bhamla-lab/OpenCell/OpenCell Raw Data.xlsx

Sheet: Time Characterization
Sample | Mass (g) | Elution (ul) | Conc (ng/ul) | A260/A280 | Yield (ng) | Time
A1 |  | 50 | 20.8 | 1.64 | 1040 | 30
A2 |  | 50 | 25.3 | 1.49 | 1265 | 30
A3 |  | 50 | 16.7 | 1.52 | 835 | 30
____
B1 |  | 50 | 27.8 | 1.8 | 1390 | 60
B2 |  | 50 | 29.3 | 1.76 | 1465 | 60
B3 |  | 50 | 19.5 | 1.77 | 975 | 60
_____
C1 |  | 50 | 41.9 | 1.8 | 2095 | 120
C2 |  | 50 | 42.7 | 1.83 | 2135 | 120
C3 |  | 50 | 48.9 | 1.84 | 2445 | 120
____
D1 |  | 50 | 55.8 | 1.82 | 2790 | 180
D2 |  | 50 | 57.3 | 1.79 | 2865 | 180
D3 |  | 50 | 53.4 | 1.82 | 2670 | 180
___
E1 |  | 50 | 60.6 | 1.82 | 3030 | 300
E2 |  | 50 | 56.1 | 1.8 | 2805 | 300
E3 |  | 50 | 58.7 | 1.81 | 2935 | 300
____
F1
F2
F3

Sheet: Speed Characterization
Sample | Mass (g) | Elution (ul) | Conc (ng/ul) | A260/A280 | Yield (ng) | Speed
A1 |  | 50 | 17.5 | 1.32 | 875 | 425
A2 |  | 50 | 6.7 | 1.62 | 335 | 425
A3 |  | 50 | 16.3 | 1.42 | 815 | 425
____
B1 |  | 50 | 15.6 | 1.69 | 780 | 550
B2 |  | 50 | 22.3 | 1.72 | 1115 | 550
B3 |  | 50 | 16.6 | 1.7 | 830 | 550
_____
C1 |  | 50 | 38.7 | 1.79 | 1935 | 725
C2 |  | 50 | 31.5 | 1.76 | 1575 | 725
C3 |  | 50 | 36.2 | 1.82 | 1810 | 725
____
D1 |  | 50 | 40 | 1.77 | 2000 | 850
D2 |  | 50 | 44.7 | 1.8 | 2235 | 850
D3 |  | 50 | 41.5 | 1.78 | 2075 | 850
___
E1 |  | 50 | 43.2 | 1.79 | 2160 | 1000
E2 |  | 50 | 48.5 | 1.82 | 2425 | 1000
E3 |  | 50 | 45.7 | 1.82 | 2285 | 1000

Sheet: Centrifuge Characterization
Sample | Mass (g) | Elution (ul) | Conc (ng/ul) | A260/A280 | Yield (ng)
A1 |  | 50 | 45.8 | 1.32 | 2290 | 0.5
A2 |  | 50 | 43.6 | 1.62 | 2180 | 0.5
A3 |  | 50 | 35.3 | 1.43 | 1765 | 0.5
____
B1 |  | 50 | 47.5 | 1.69 | 2375 | 1
B2 |  | 50 | 43.3 | 1.62 | 2165 | 1
B3 |  | 50 | 50.7 | 1.7 | 2535 | 1
_____
C1 |  | 50 | 51.3 | 1.79 | 2565 | 1.5
C2 |  | 50 | 54.7 | 1.76 | 2735 | 1.5
C3 |  | 50 | 52.5 | 1.72 | 2625 | 1.5
____
D1 |  | 50 | 51.8 | 1.77 | 2590 | 2
D2 |  | 50 | 52.6 | 1.8 | 2630 | 2
D3 |  | 50 | 55.9 | 1.76 | 2795 | 2
___
E1 |  | 50 | 53.4 | 1.81 | 2670 | 2.5
E2 |  | 50 | 53.5 | 1.84 | 2675 | 2.5
E3 |  | 50 | 54.7 | 1.8 | 2735 | 2.5

Sheet: OCX vs Commercial
Sample | Mass (g) | Elution (ul) | Conc (ng/ul) | A260/A280 | Yield (ng)
A1 | 0.0508 | 50 | 59.2 | 1.76 | 2960
 | 0.0508 | 50 | 55.1 | 1.74 | 2755 | 1.75 | 2857.5
A2 | 0.0492 | 50 | 48.5 | 1.77 | 2425
 | 0.0492 | 50 | 48.9 | 1.74 | 2445 | 1.755 | 2435
A3 | 0.0495 | 50 | 50 | 1.82 | 2500
 | 0.0495 | 50 | 50.1 | 1.76 | 2505 | 1.79 | 2502.5
A4 | 0.0497 | 50 | 34.1 | 1.76 | 1705
 | 0.0497 | 50 | 34.4 | 1.76 | 1720 | 1.76 | 1712.5
A5 | 0.0506 | 50 | 40.8 | 1.74 | 2040
 | 0.0506 | 50 | 40.2 | 1.74 | 2010 | 1.74 | 2025
A6 | 0.0503 | 50 | 38.2 | 1.72 | 1910
 | 0.0503 | 50 | 36.2 | 1.74 | 1810 | 1.73 | 1860
A7 | 0.0504 | 50 | 47.6 | 1.73 | 2380
 | 0.0504 | 50 | 43.3 | 1.71 | 2165 | 1.72 | 2272.5
____
B1 | 0.0505 | 50 | 45.9 | 1.83 | 2295
 | 0.0505 | 50 | 43.2 | 1.79 | 2160 | 1.81 | 2227.5
B2 | 0.05 | 50 | 55.9 | 1.77 | 2795
 | 0.05 | 50 | 55.4 | 1.77 | 2770 | 1.77 | 2782.5
B3 | 0.0505 | 50 | 44.8 | 1.82 | 2240
 | 0.0505 | 50 | 45.1 | 1.82 | 2255 | 1.82 | 2247.5
B4 | 0.0503 | 50 | 45 | 1.75 | 2250
 | 0.0503 | 50 | 45.4 | 1.75 | 2270 | 1.75 | 2260
B5 | 0.0494 | 50 | 45.2 | 1.81 | 2260
 | 0.0494 | 50 | 45.1 | 1.8 | 2255 | 1.805 | 2257.5
B6 | 0.0502 | 50 | 45.5 | 1.82 | 2275
 | 0.0502 | 50 | 46.1 | 1.82 | 2305 | 1.82 | 2290
B7 | 0.0496 | 50 | 51.2 | 1.8 | 2560
 | 0.0496 | 50 | 51.4 | 1.79 | 2570 | 1.795 | 2565
____
C1 | 0.0502 | 50 | 1.5 | 1.28 | 75 | 1494.023904
C2 | 0.0496 | 50 | 2.4 | 1.3 | 120 | 2419.354839
C3 | 0.0504 | 50 | 1.6 | 1.24 | 80 | 1587.301587
C4 | 0.0503 | 50 | 1.6 | 1.26 | 80 | 1590.457256
C5 | 0.0502 | 50 | 1.9 | 1.29 | 95 | 1892.430279

Sheet: GEL
GEL | PCR | Extraction
1 | Ladder
2 | A | A3
3 | B | A4
4 | C | A5
5 | D | A7
6
7 | Ladder
8 | E | B3
9 | F | B4
10 | G | B5
11 | H | B6
12 | TEST | (A1)
13

Sheet: High Speed Tracking
Time | 560 RPM | 700 RPM | 800 RPM | 1000 RPM
0 | -35.75543857 | -35.52404484 | -36.2382883 | -35.52308178
0.00022543 | -35.88779777 | -36.04226227 | -36.56577593 | -35.63879852
0.00045086 | -35.45374428 | -35.54677528 | -36.42872528 | -35.7624298
0.00067628 | -35.4414147 | -34.98313727 | -36.38749202 | -35.14864865
0.00090171 | -35.41839807 | -35.6372435 | -35.94955959 | -35.28809372
0.00112714 | -34.94925267 | -35.42057309 | -35.65259904 | -35.34769076
0.00135257 | -34.52787957 | -35.98616935 | -36.35921868 | -34.858677
0.001578 | -34.71435647 | -35.84451274 | -36.16508656 | -35.17989385
0.00180343 | -34.78617925 | -35.77580336 | -36.33334219 | -35.33193965
0.00202885 | -34.6235922 | -35.86993852 | -35.9289952 | -35.16734282
0.00225428 | -34.86983095 | -35.25020861 | -35.79301172 | -35.20688794
0.00247971 | -34.69298589 | -35.54009208 | -36.17531276 | -35.28925854
0.00270514 | -34.83938178 | -34.80196914 | -35.98149678 | -35.18253027
0.00293057 | -34.11354627 | -34.73131728 | -36.16573586 | -35.11332904
0.003156 | -34.20888934 | -34.98559613 | -35.62898615 | -34.85259407
0.00338142 | -34.18095869 | -35.02464924 | -35.54104655 | -35.03985329
0.00360685 | -33.84301151 | -35.33750341 | -35.97091755 | -34.81114285
0.00383228 | -34.55751446 | -34.69764365 | -35.56003494 | -34.91100359
0.00405771 | -34.3906868 | -35.12081467 | -36.00930667 | -35.22079401
0.00428314 | -34.37292448 | -35.03177248 | -35.88035619 | -34.87837015
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
0.10504959 | -35.32602402
0.10527502 | -35.38032305
0.10550045 | -35.01405862
0.10572588 | -35.37101043
0.10595131 | -35.10039014
0.10617674 | -34.86444053
0.10640216 | -35.41439969
0.10662759 | -35.15540144
0.10685302 | -35.31554958
0.10707845 | -35.10895664
0.10730388 | -34.90107331
