bhamla-lab/OpenCell/STL Files/Centrifuge Attachment/Centrifuge Attachment.stl

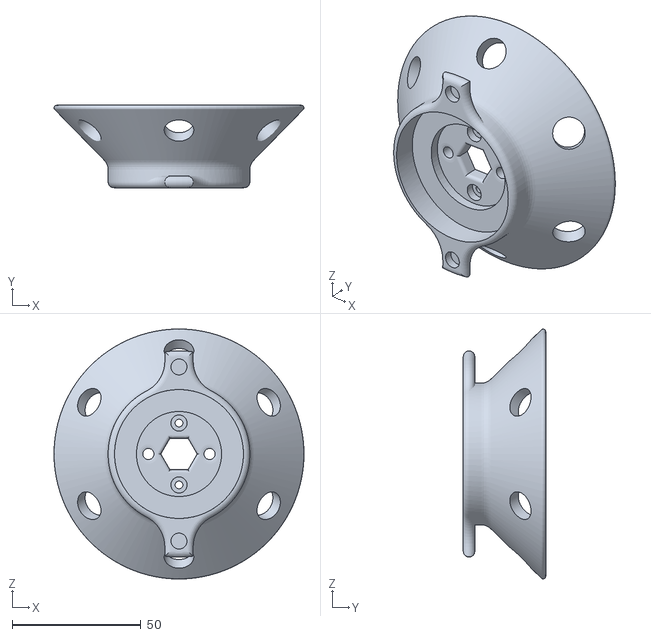
[picture p1: CAD file, 2023-09-28]
STL Files/Centrifuge Attachment/Centrifuge Attachment.stl
97.0 x 32.0 x 97.0
