bhamla-lab/OpenCell/STL Files/Lysis Attachment/Secondary Gear.stl

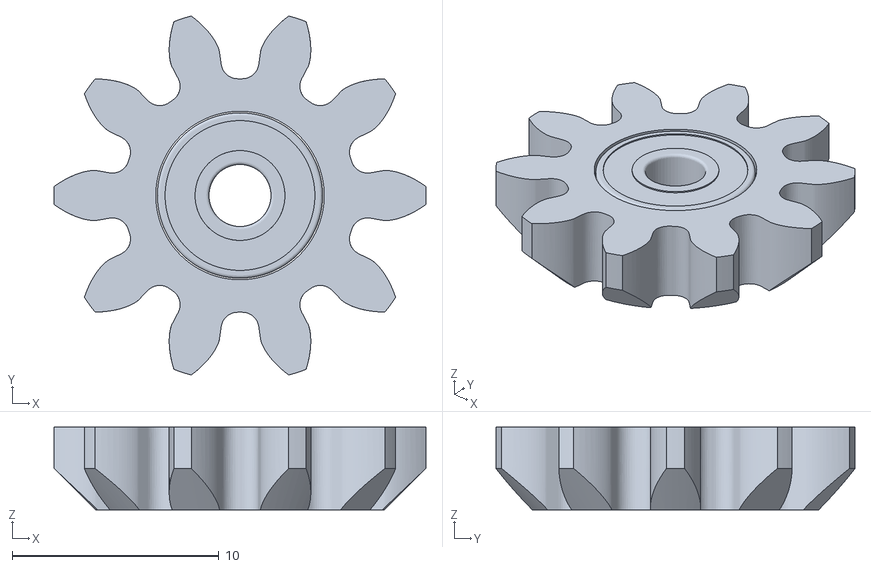
[picture p2: CAD file, 2023-10-03]
STL Files/Lysis Attachment/Secondary Gear.stl
18.0 x 17.4 x 4.00
