bhamla-lab/OpenCell/STL Files/Platform/Button Holder.stl

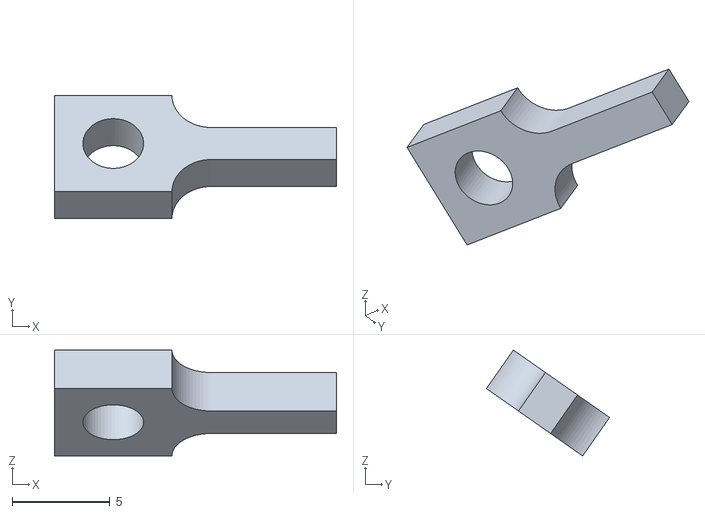
[picture p3: CAD file, 2023-10-03]
STL Files/Platform/Button Holder.stl
14.4 x 6.29 x 5.41
