bhamla-lab/OpenCell/STL Files/Lysis Attachment/Tertiary Gear.stl

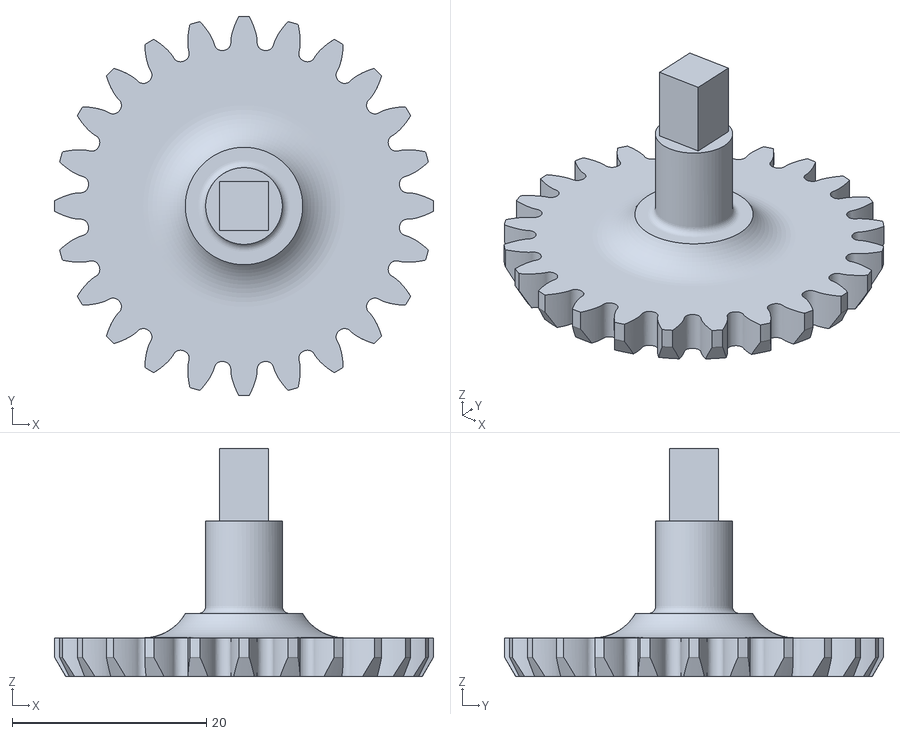
[picture p4: CAD file, 2023-10-03]
STL Files/Lysis Attachment/Tertiary Gear.stl
39.0 x 39.0 x 23.5
