bhamla-lab/OpenCell/STL Files/Platform/Face.stl

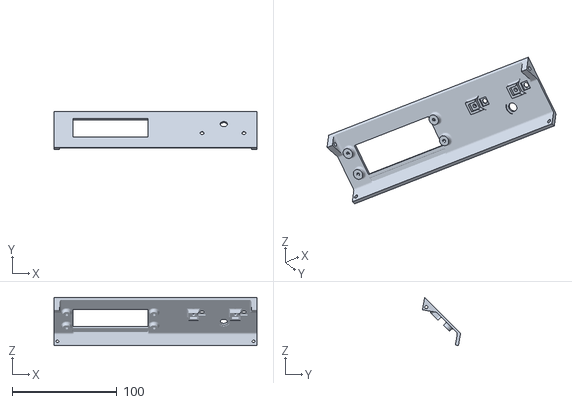
[picture p5: CAD file, 2023-10-03]
STL Files/Platform/Face.stl
194.0 x 36.5 x 46.0
