bhamla-lab/OpenCell/STL Files/Lysis Attachment/Tube Strap.stl

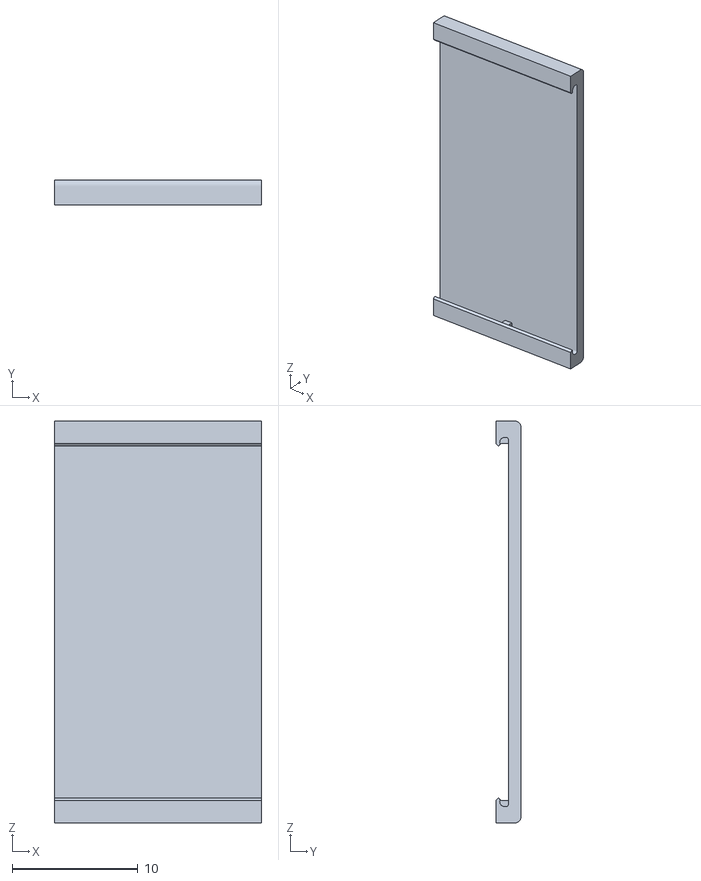
[picture p6: CAD file, 2023-09-28]
STL Files/Lysis Attachment/Tube Strap.stl
16.5 x 2.00 x 32.0
