bhamla-lab/OpenCell/STL Files/Platform/Electronics Enclosure.stl

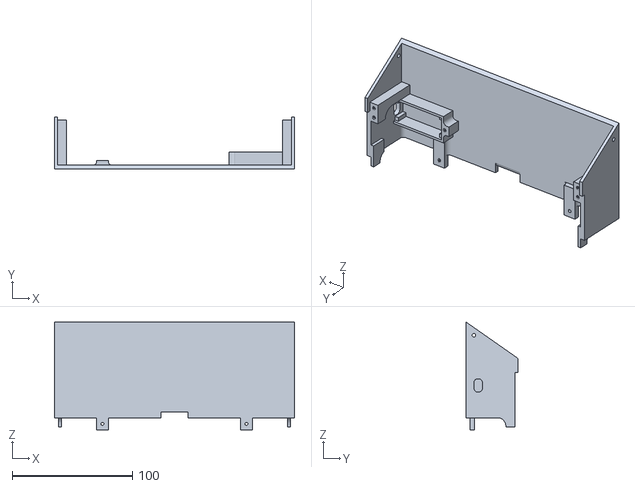
[picture p7: CAD file, 2023-10-03]
STL Files/Platform/Electronics Enclosure.stl
200.0 x 43.0 x 89.8
