bhamla-lab/OpenCell/STL Files/Lysis Attachment/Tube Cradle Base.stl

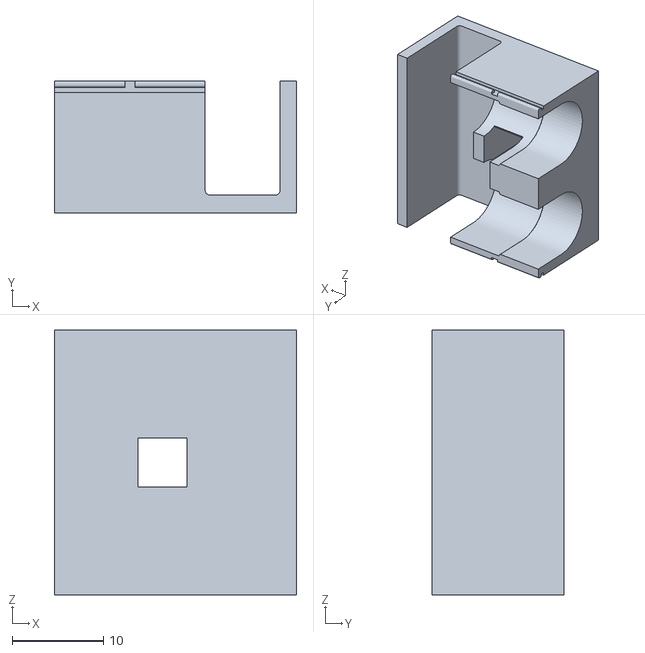
[picture p8: CAD file, 2023-03-24]
STL Files/Lysis Attachment/Tube Cradle Base.stl
26.5 x 14.5 x 29.0
