bhamla-lab/OpenCell/STL Files/Platform/Electronics Lid.stl

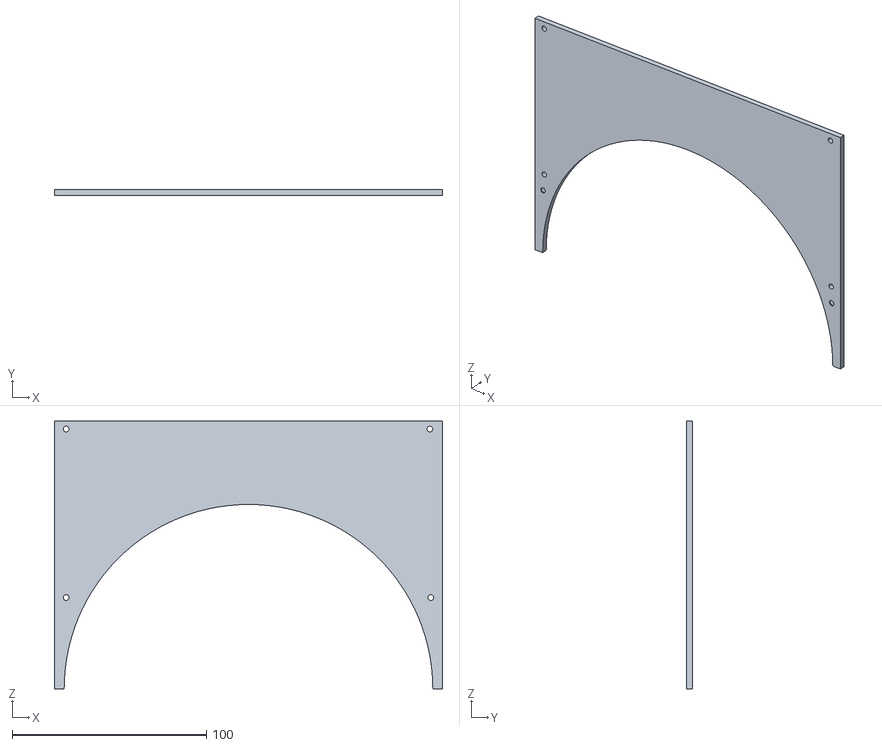
[picture p9: CAD file, 2023-09-28]
STL Files/Platform/Electronics Lid.stl
200.0 x 3.00 x 137.9
