bhamla-lab/OpenCell/STL Files/Lysis Attachment/Lower Arm.stl

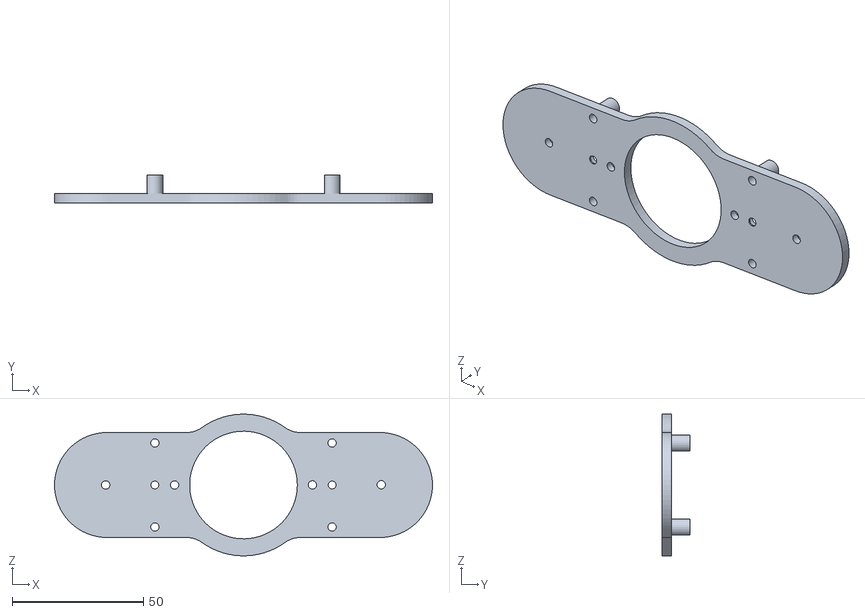
[picture p10: CAD file, 2023-03-24]
STL Files/Lysis Attachment/Lower Arm.stl
144.0 x 10.5 x 54.0
