bhamla-lab/OpenCell/STL Files/Platform/Chamber.stl

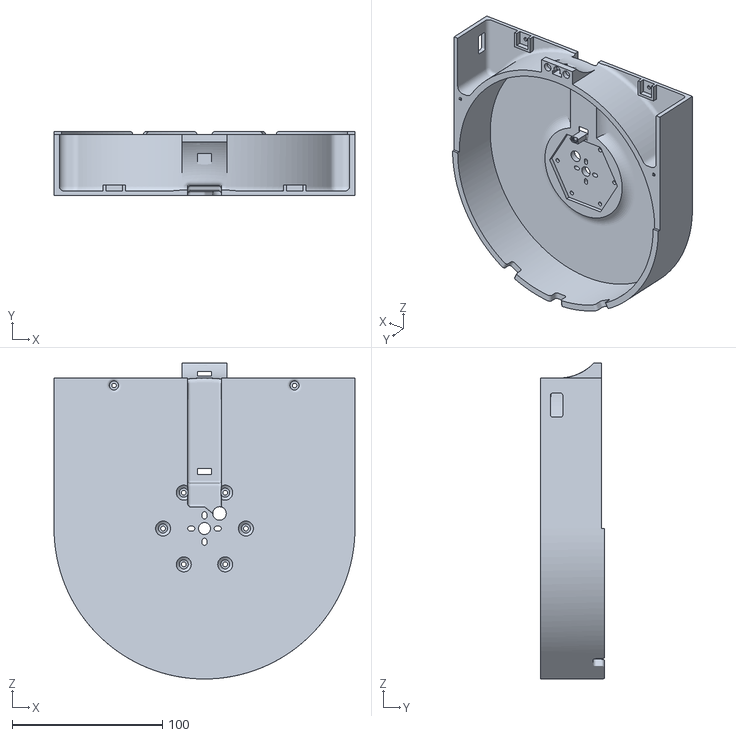
[picture p11: CAD file, 2023-09-28]
STL Files/Platform/Chamber.stl
200.0 x 42.5 x 210.0
