bhamla-lab/OpenCell/STL Files/Lysis Attachment/Upper Arm.stl

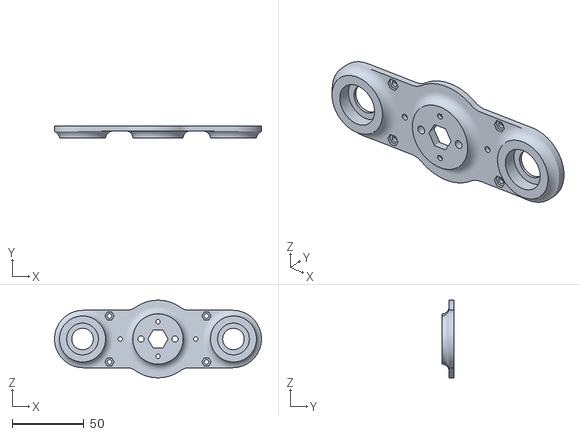
[picture p12: CAD file, 2023-03-24]
STL Files/Lysis Attachment/Upper Arm.stl
144.0 x 8.50 x 54.0
