bhamla-lab/OpenCell/STL Files/Platform/Lid.stl

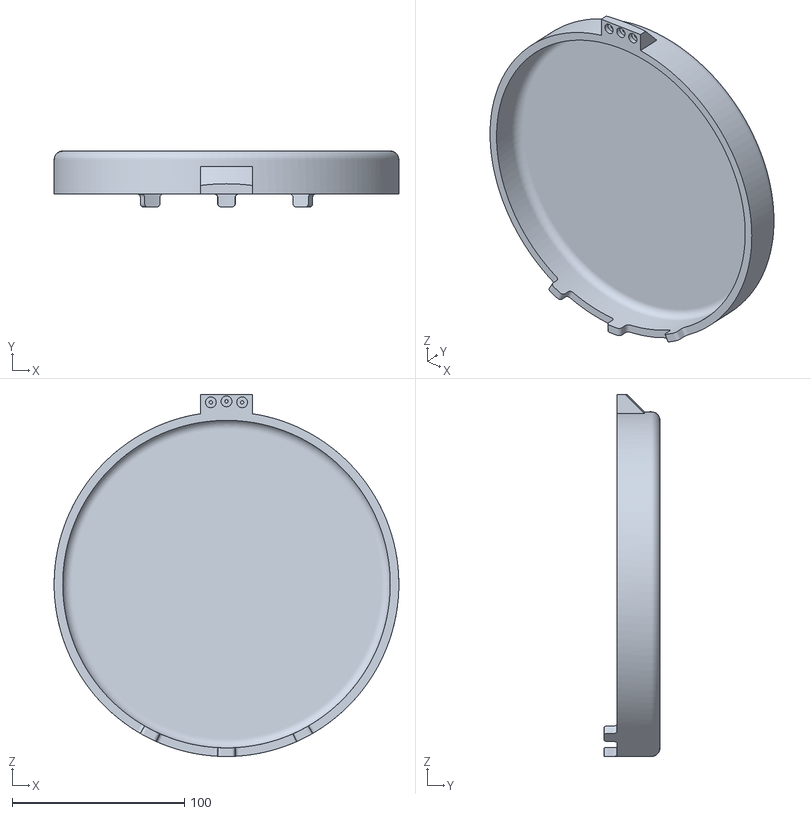
[picture p13: CAD file, 2023-09-28]
STL Files/Platform/Lid.stl
200.0 x 32.5 x 210.0
