bhamla-lab/OpenCell/STL Files/Platform/Motor Mount.stl

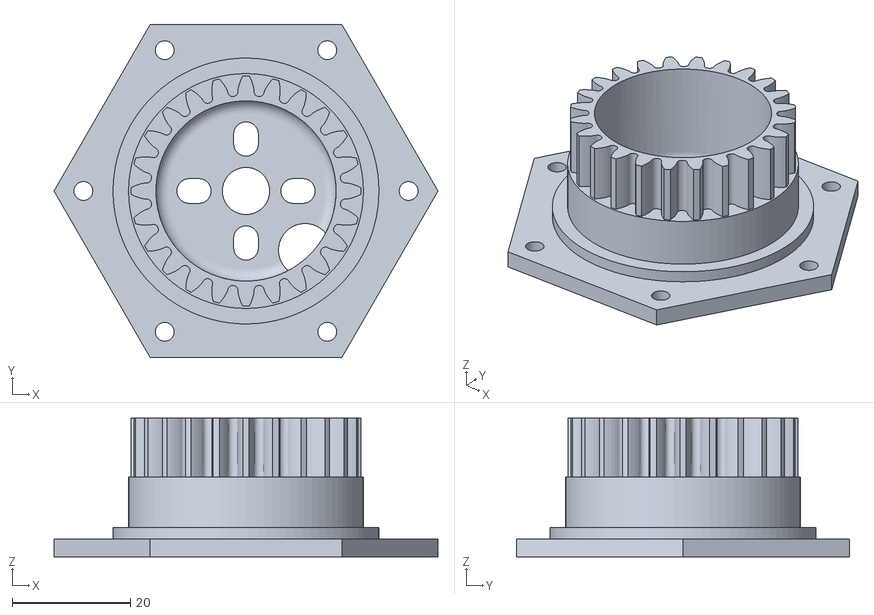
[picture p14: CAD file, 2023-03-24]
STL Files/Platform/Motor Mount.stl
65.0 x 56.3 x 23.5
