bhamla-lab/OpenCell/STL Files/Platform/Quick Release Mount.stl

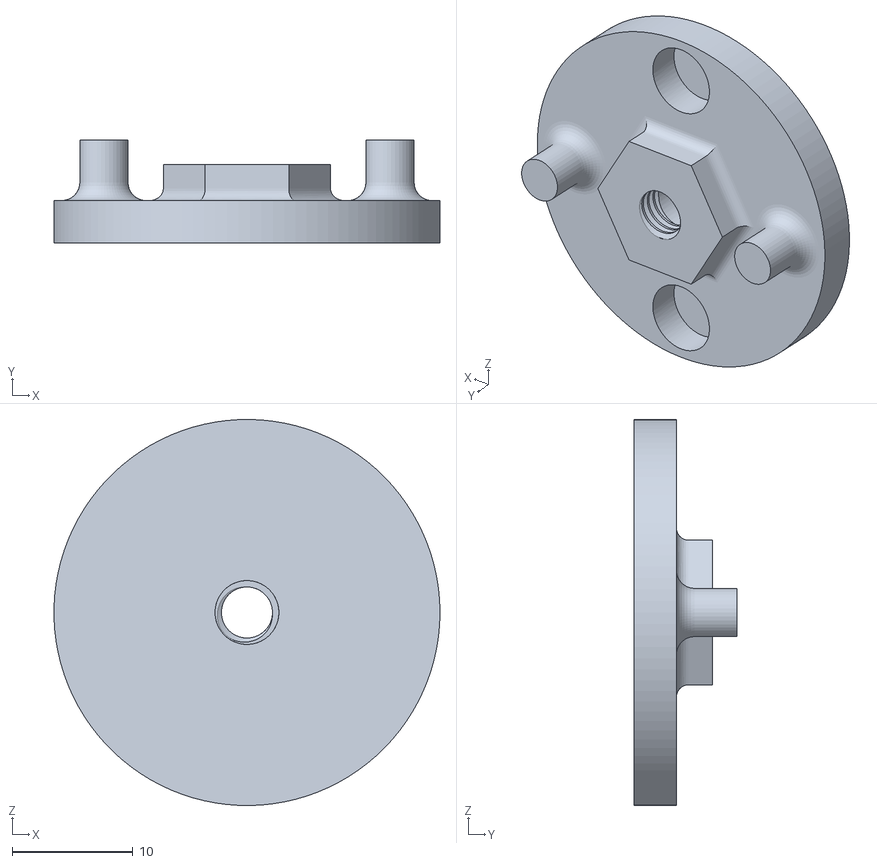
[picture p15: CAD file, 2023-03-24]
STL Files/Platform/Quick Release Mount.stl
32.0 x 8.50 x 32.0
