bhamla-lab/OpenCell/OpenCell_PID/OpenCell_PID.ino

//OPENCELL PID CODE
//BhamlaLab - Georgia Institute of Technology
//Aryan Gupta

//USING CODE ADAPTED FROM https://www.youtube.com/watch?v=u2uJMJWsfsg
/*
  This verion of the code is reccomended for experienced programmers. A PID allows for accurate and precise control.
  A PID must be tuned and improper implementation can lead to instability, component damage, and overheating.
  We reccomend a low Kp value and a slightly overdamped system.
*/

#include <Servo.h>
#include <Wire.h>
#include <LiquidCrystal_I2C.h>
#define rightBtn 5
#define leftBtn 4
#define dial A3
#define tach 2
#define motor 3
#define lidSensor 6
float Kp = 0;
float Ki = 0;
float Kd = 0;
float Kc = 0;
float FF = 0;

float Kpc = 0;
float Kic = 0;
float Kdc = 0;
float Kcc = 0; 
float FFc = 0;

float rateLimiter = 100;
int mode = 0;
LiquidCrystal_I2C lcd(0x27, 16, 2);
Servo esc;
int potValue;
unsigned long lastTime_print = 0;


const byte PulsesPerRevolution = 2;  // Set how many pulses there are on each revolution. Default: 2.
const unsigned long ZeroTimeout = 200000;
const byte numReadings = 2;

volatile unsigned long LastTimeWeMeasured;
volatile unsigned long PeriodBetweenPulses = ZeroTimeout + 1000; 
volatile unsigned long PeriodAverage = ZeroTimeout + 1000;
unsigned long FrequencyRaw;
unsigned long FrequencyReal;
unsigned long RPM;
unsigned int PulseCounter = 1;

unsigned long PeriodSum;
unsigned long LastTimeCycleMeasure = LastTimeWeMeasured;

unsigned long CurrentMicros = micros();

unsigned int AmountOfReadings = 1;

unsigned int ZeroDebouncingExtra;


unsigned long readings[numReadings];
unsigned long readIndex;
unsigned long total;
unsigned long average;

void setup()  // Start of setup:
{
  pinMode(rightBtn, INPUT_PULLUP);
  pinMode(leftBtn, INPUT_PULLUP);
  pinMode(dial, INPUT);
  Serial.begin(9600);
  attachInterrupt(digitalPinToInterrupt(tach), Pulse_Event, FALLING);

  lcd.begin();
  lcd.backlight();
  lcd.clear();
  esc.attach(motor, 1000, 2000); 
  esc.writeMicroseconds(1000);
  delay(1000); 

}  // End of setup.


void loop()  // Start of loop:
{
  homogenize();
}


void updateLCD(int power, int timeLeft) {
  if ((millis() - lastTime_print) >= 500) {
    int pwr = map(power, 1000, 1400, 0, 100);
    lastTime_print = millis();
    lcd.clear();
    lcd.setCursor(0, 0);
    lcd.print("Time: ");
    lcd.setCursor(10, 0);
    lcd.print(timeLeft);
    lcd.setCursor(0, 1);
    lcd.print("RPM:");
    lcd.print(average);
    lcd.setCursor(9, 1);
    lcd.print("P:");
    lcd.print(pwr);
    // Serial.print("Period: ");
    // Serial.print(PeriodBetweenPulses);
    // Serial.print("\tReadings: ");
    // Serial.print(AmountOfReadings);
    // Serial.print("\tFrequency: ");
    // Serial.print(FrequencyReal);
    // Serial.print("\tRPM: ");
    // Serial.print(RPM);
    // Serial.print("\tTachometer: ");
    // Serial.println(average);

  }
}

void initializeOpenCell() {
  lcd.clear();
  lcd.setCursor(4, 0);
  lcd.print("OpenCell");
  lcd.setCursor(0, 1);
  lcd.print("Science for All!");
  delay(2000);
}


void startScreen() {
  lcd.clear();
  lcd.setCursor(4, 0);
  lcd.print("OpenCell");
  lcd.setCursor(1, 1);
  lcd.print("Press To Start");
}

void modeSelect() {
  lcd.clear();
  lcd.setCursor(2,0);
  lcd.print("Mode Select:");
  lcd.setCursor(1,1);
}


void setTime() {
  lcd.clear();
  lcd.setCursor(4, 0);
  lcd.print("Set Time");
  lcd.setCursor(1, 1);
}

void setSpeed() {
  lcd.clear();
  lcd.setCursor(4, 0);
  lcd.print("Set Speed");
  lcd.setCursor(1, 1);
}




int runHomogenizer(float duration, float runSpeed) {
  lcd.clear();
  lcd.setCursor(0,0);
  lcd.print("Starting");
  delay(1000);
  float msTime = duration * 1000 * 60;
  long startTime = millis();
  long endTime = startTime + msTime;
  int timeElapsed = 0;
  int printTime = 0;
  float error = 0;
  float cumulativeError = 0;
  float deltaError = 0;
  float lastError = 0;
  float outputValue = 0;

  if(mode == 2){
    Kp = Kpc;
    Ki = Kic;
    Kd = Kdc;
    Kc = Kcc;
    FF = FFc;
  }
  float lastOutput = 1000;
  while (millis() < endTime) {

    error = runSpeed - average;
    cumulativeError += error;

    deltaError = error - lastError;
    lastError = error;

    outputValue = Kp*error + Ki*cumulativeError + Kd*deltaError + (runSpeed*Kc + FF);;

    if(outputValue > lastOutput + rateLimiter){
      outputValue = lastOutput + rateLimiter;
    }
    else if(outputValue < lastOutput - rateLimiter){
      outputValue = lastOutput - rateLimiter;
    }

    lastOutput = outputValue;
    Serial.print("error: ");
    Serial.print(error);

    Serial.print(", CE: ");
    Serial.print(cumulativeError);
    
    Serial.print(", DE: ");
    Serial.print(deltaError);


    if(outputValue < 1000) outputValue = 1000;
    if(outputValue > 1400) outputValue = 1400;
    Serial.print(", Output:");
    Serial.println(outputValue);
    if((digitalRead(rightBtn) == 0) || (digitalRead(leftBtn) == 0)){
      esc.writeMicroseconds(0);
      endTime = 0; 
    }
    if(digitalRead(lidSensor) < 1) {
      esc.writeMicroseconds(outputValue);
    }
    else{
       esc.writeMicroseconds(0);
       //endTime = 0;
    }

    printTime = (endTime - millis()) / 1000;
    updateLCD(outputValue, printTime);
    checkSpeed();
  }
  esc.write(0);
  lcd.clear();
  lcd.setCursor(2, 0);
  lcd.print("OpenCell Pro");
  lcd.setCursor(1, 1);
  lcd.print("Finished");
  delay(1000);
}



int homogenize() {
  int  pwmOut = 0;
  bool timeSet = false;
  bool speedSet = false;
  bool modeSet = false;

  float runTime;
  float runSpeed;
  
  lcd.begin();
  lcd.backlight();
  lcd.setCursor(1, 0);
  initializeOpenCell();
  startScreen();

  while (digitalRead(rightBtn) == 1) {}

  //SET MODE
  modeSelect();
  delay(1000);
  while(modeSet == false) {
    potValue = analogRead(A3);
    potValue = map(potValue, 0, 1023, 0, 10);
    if(potValue > 3) {
      mode = 2;
      lcd.setCursor(3,1);
      lcd.print("Centrifuge");
    }
    else{
      mode = 1;
      lcd.setCursor(3,1);
      lcd.print("Cell Lysis");
    }

    if(digitalRead(rightBtn) == 0){
      modeSet = true;
    }

  }

  //SET RUN TIME

  setTime();
  delay(1000);
  while (timeSet == false) {
    potValue = analogRead(A3);
    potValue = map(potValue,0,1023, 0, 80);
    float timer = potValue / 8.00;
    lcd.setCursor(5, 1);
    lcd.print(timer);
    if (digitalRead(rightBtn) == 0) {
      runTime = timer;
      timeSet = true;
    }
  }

  //SET RUN SPEED
  delay(1000);
  setSpeed();
  delay(1000);
  while (speedSet == false) {
    potValue = analogRead(A3);
    if(mode == 2) runSpeed = map(potValue,0,1023, 3500, 7000);
    if(mode == 1) runSpeed = map(potValue,0,1023, 500, 1250);
    lcd.setCursor(5, 1);
    lcd.print(runSpeed);
    if (digitalRead(rightBtn) == 0) {
      speedSet = true;
    }
  }
  delay(1000);


  //RUN HOMOGENIZER
  runHomogenizer(runTime, runSpeed);
}

void checkSpeed() {
  LastTimeCycleMeasure = LastTimeWeMeasured;
  CurrentMicros = micros();
  if (CurrentMicros < LastTimeCycleMeasure)
  {
    LastTimeCycleMeasure = CurrentMicros;
  }

  FrequencyRaw = 10000000000 / PeriodAverage;

  if (PeriodBetweenPulses > ZeroTimeout - ZeroDebouncingExtra || CurrentMicros - LastTimeCycleMeasure > ZeroTimeout - ZeroDebouncingExtra)
  {
    FrequencyRaw = 0;
    ZeroDebouncingExtra = 2000;
  }
  else
  {
    ZeroDebouncingExtra = 0;
  }

  FrequencyReal = FrequencyRaw / 10000;
  RPM = FrequencyRaw / PulsesPerRevolution * 60;
  RPM = RPM / 10000; 


  total = total - readings[readIndex];
  readings[readIndex] = RPM;
  total = total + readings[readIndex];
  readIndex = readIndex + 1;

  if (readIndex >= numReadings) readIndex = 0;

  // Calculate the average:
  average = total / numReadings;

}


void Pulse_Event()  // The interrupt runs this to calculate the period between pulses:
{
  PeriodBetweenPulses = micros() - LastTimeWeMeasured; 
  LastTimeWeMeasured = micros();

  if (PulseCounter >= AmountOfReadings)
  {
    PeriodAverage = PeriodSum / AmountOfReadings;
    PulseCounter = 1;
    PeriodSum = PeriodBetweenPulses;

    int RemapedAmountOfReadings = map(PeriodBetweenPulses, 40000, 5000, 1, 10);
    RemapedAmountOfReadings = constrain(RemapedAmountOfReadings, 1, 10);
    AmountOfReadings = RemapedAmountOfReadings;
  }
  else
  {
    PulseCounter++;
    PeriodSum = PeriodSum + PeriodBetweenPulses;
  }

}
