bhamla-lab/OpenCell/(commit log)

2023-03-24 STL Upload
    [Chamber.stl, Electronics Lid.stl, Enclosure.stl, Face.stl, Lower Arm.stl, Motor Mount.stl, Quick Release Mount.stl, Secondary Geary.stl]
2023-09-28 Delete STL Files directory
    Outdated Files
    [Chamber.stl, Electronics Chamber.stl, Electronics Enclosure.stl, Electronics Lid.stl, Enclosure.stl, Face.stl, Lower Arm.stl, Motor Mount.stl]
2023-09-28 Updated STL Files
    [Centrifuge Attachment.stl, Chamber.stl, Electronics Enclosure.stl, Electronics Lid.stl, Face.stl, Lid.stl, Lower Arm.stl, Motor Mount.stl]
2023-10-18 Update OpenCell_PID.ino
    Added Rate Limiter
    Added FF component to PID
